hnz1102/GNNS-viewwer/hw/BOM.csv

Reference | Qty | Value | DNP | Footprint | digikey/other
C1,C3 | 2 | 16pF |  | Capacitor_SMD:C_0603_1608Metric | 1292-1490-1-ND
C2,C4,C5,C6,C7,C8,C11,C13,C15 | 9 | 0.1uF |  | Capacitor_SMD:C_0603_1608Metric | 311-1344-1-ND
C9,C10,C18 | 3 | 1uF |  | Capacitor_SMD:C_0805_2012Metric | 1276-1026-1-ND
C12 | 1 | 10nF |  | Capacitor_SMD:C_0603_1608Metric | 311-1085-1-ND
C14,C17 | 2 | 10uF |  | Capacitor_SMD:C_0805_2012Metric | 1276-1096-1-ND
C16 | 1 | 4.7uF |  | Capacitor_SMD:C_0805_2012Metric | 1276-1244-1-ND
D1 | 1 | LED BLUE |  | LED_SMD:LED_0603_1608Metric | 3147-B1931NB--20C007614U1930CT-ND
D2 | 1 | CUS10F30 |  | Diode_SMD:D_SOD-323 | CUS10F30H3FCT-ND
D3 | 1 | LED RED |  | LED_SMD:LED_0603_1608Metric | 3147-B1931URO-20D000114U1930CT-ND
D4 | 1 | LED GREEN |  | LED_SMD:LED_0603_1608Metric | 3147-B1911PG--20D000514U1930CT-ND
FB1,FB2 | 2 | MH2029-601Y |  | Inductor_SMD:L_0805_2012Metric | MH2029-601YCT-ND
J1,J2 | 2 | U.FL-R-SMT-1 |  | Connector_Coaxial:U.FL_Hirose_U.FL-R-SMT-1_Vertical | 26-U.FL-R-SMT-1(80)CT-ND
J3 | 1 | USB4105-GF-A |  | Library:USB_C_5077CR-16-SMC2-BK-TR | 2073-USB4105-GF-ACT-ND
J4 | 1 | B2B-PH-K-S |  | Connector_JST:JST_PH_B2B-PH-K_1x02_P2.00mm_Vertical | 455-1704-ND
L1 | 1 | 47nH |  | Inductor_SMD:L_0603_1608Metric | 490-6582-1-ND
Q1 | 1 | 2N7002K |  | Package_TO_SOT_SMD:SOT-23 | 5399-2N7002KCT-ND
Q2 | 1 | SSM6L56FE_LM |  | Library:SOT-563ES6_TOS | 264-SSM6L56FELMCT-ND
Q3 | 1 | SSM3J332R |  | Package_TO_SOT_SMD:SOT-23 | 4518-SSM3J332RCT-ND
R1,R2,R20 | 3 | 20K 1% |  | Resistor_SMD:R_0603_1608Metric | 311-20.0KHRCT-ND
R3,R4,R5,R8,R9,R12 | 6 | 10K |  | Resistor_SMD:R_0603_1608Metric | 13-RC0603JR-1010KLCT-ND
R6,R7,R10,R11 | 4 | 1K |  | Resistor_SMD:R_0603_1608Metric | 311-1.00KHRCT-ND
R13,R23,R24 | 3 | 330 |  | Resistor_SMD:R_0603_1608Metric | 13-RC0603JR-13330RLCT-ND
R14,R22 | 2 | 100K |  | Resistor_SMD:R_0603_1608Metric | 311-100KGRCT-ND
R15 | 1 | 10 1/8W |  | Resistor_SMD:R_0805_2012Metric | 541-10.0CCT-ND
R16 | 1 | 49.9 |  | Resistor_SMD:R_0603_1608Metric | 311-49.9HRCT-ND
R17,R18 | 2 | 5.1K |  | Resistor_SMD:R_0603_1608Metric | 311-5.1KGRCT-ND
R19 | 1 | 2K |  | Resistor_SMD:R_0603_1608Metric | 311-2.0KGRCT-ND
R21 | 1 | 12K 1% |  | Resistor_SMD:R_0603_1608Metric | 311-12.0KCRT-ND
SW1 | 1 | PAGE/BOOT |  | Button_Switch_THT:SW_PUSH_6mm_H8mm | 2223-TS02-66-70-BK-160-LCR-D-ND
SW2 | 1 | ZOOM-IN |  | Button_Switch_THT:SW_PUSH_6mm_H8mm | 2223-TS02-66-70-BK-160-LCR-D-ND
SW3 | 1 | MODE |  | Button_Switch_THT:SW_PUSH_6mm_H8mm | 2223-TS02-66-70-BK-160-LCR-D-ND
SW4 | 1 | ZOOM-OUT |  | Button_Switch_THT:SW_PUSH_6mm_H8mm | 2223-TS02-66-70-BK-160-LCR-D-ND
SW5 | 1 | SLIDE_SW |  | Library:SLIDE_SW_IS1235-G | SLIDE_SW_IS1235-G https://akizukidenshi.com/catalog/g/g115368/
U1 | 1 | ESP32-S3-WROOM-1-N16R8 |  | Library:ESP32-S3-WROOM-1_EXP | 1965-ESP32-S3-WROOM-1-N16R8CT-ND
U2 | 1 | ST7789V_TFT_DISPLAY_8P |  | Library:ST7789V TFT SPI DISPLAY 320x240 GMT020-02-8P | GMT020-02-8P
U3 | 1 | FEMC064G-M11 |  | Library:EM32VSUKN FPGA153 | 3052-FEMC064G-M11-ND
U4 | 1 | MAX-F10S-00B |  | Library:MAX-F10S_UBL | 672-MAX-F10S-00BCT-ND
U5 | 1 | SPX3819M5-L |  | Package_TO_SOT_SMD:SOT-23-5 | 1016-1871-1-ND
U6 | 1 | MCP73831T-2ATI/OT |  | Package_TO_SOT_SMD:SOT-23-5 | MCP73831T-2ATI/OTCT-ND
Y1 | 1 | 32.7680KHz |  | Crystal:Crystal_SMD_3215-2Pin_3.2x1.5mm | 2151-RT3215-32.768-12.5-TRCT-ND
