hnz1102/GNNS-viewwer/hw/production/bom.csv

Designator | Footprint | Quantity | Value | LCSC Part #
C1, C3 | 0603 | 2 | 16pF
C10, C18, C9 | 0805 | 3 | 1uF
C11, C13, C15, C2, C4, C5, C6, C7, C8 | 0603 | 9 | 0.1uF
C12 | 0603 | 1 | 10nF
C14, C17 | 0805 | 2 | 10uF
C16 | 0805 | 1 | 4.7uF
D1 | 0603 | 1 | LED BLUE
D2 | D_SOD-323 | 1 | CUS10F30
D3 | 0603 | 1 | LED RED
D4 | 0603 | 1 | LED GREEN
FB1, FB2 | 0805 | 2 | MH2029-601Y
J1, J2 | U.FL_Hirose_U.FL-R-SMT-1_Vertical | 2 | Conn_Coaxial
J3 | USB_C_5077CR-16-SMC2-BK-TR | 1 | USB4105-GF-A
J4 | JST_PH_B2B-PH-K_1x02_P2.00mm_Vertical | 1 | LiPo BATTERY
L1 | 0603 | 1 | 47nH
Q1 | SOT-23 | 1 | 2N7002K
Q2 | SOT-563ES6_TOS | 1 | SSM6L56FE_LM
Q3 | SOT-23 | 1 | SSM3J332R
R1, R2, R20 | 0603 | 3 | 20K 1%
R10, R11, R6, R7 | 0603 | 4 | 1K
R12, R3, R4, R5, R8, R9 | 0603 | 6 | 10K
R13, R23, R24 | 0603 | 3 | 330
R14, R22 | 0603 | 2 | 100K
R15 | 0805 | 1 | 10 1/4W
R16 | 0603 | 1 | 49.9
R17, R18 | 0603 | 2 | 5.1K
R19 | 0603 | 1 | 2K
R21 | 0603 | 1 | 12K 1%
SW1 | SW_PUSH_6mm_H8mm | 1 | PAGE/BOOT
SW2 | SW_PUSH_6mm_H8mm | 1 | ZOOM-IN
SW3 | SW_PUSH_6mm_H8mm | 1 | MODE
SW4 | SW_PUSH_6mm_H8mm | 1 | ZOOM-OUT
SW5 | SLIDE_SW_IS1235-G | 1 | SLIDE_SW
U1 | ESP32-S3-WROOM-1_EXP | 1 | ESP32-S3-WROOM-1-N16R8
U2 | ST7789V TFT SPI DISPLAY 320x240 GMT020-02-8P | 1 | ST7789V_TFT_DISPLAY_8P
U3 | EM32VSUKN FPGA153 | 1 | EM64VSUKN-BA000-2
U4 | MAX-F10S_UBL | 1 | MAX-F10S-00B
U5 | SOT-23-5 | 1 | SPX3819M5-L
U6 | SOT-23-5 | 1 | MCP73831-2-OT
Y1 | Crystal_SMD_3215-2Pin_3.2x1.5mm | 1 | 32.7680KHz
