hnz1102/GNNS-viewwer/STL/bottom.stl

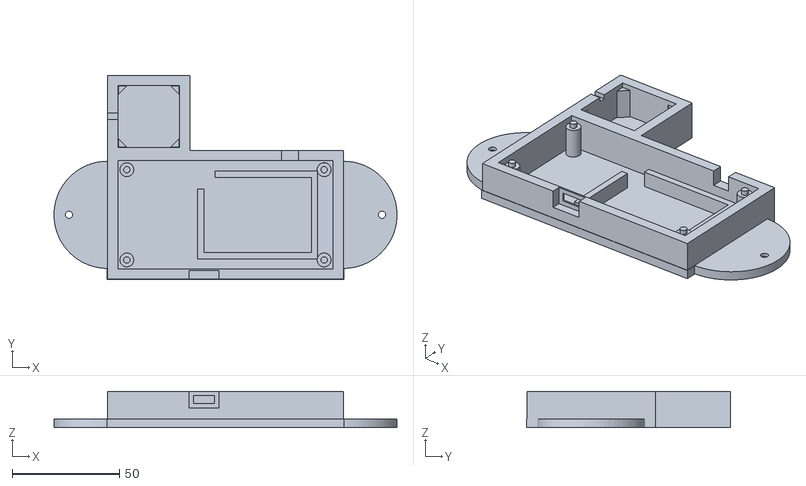
[picture p22: CAD file, 2026-10-10]
STL/bottom.stl
159.9 x 95.2 x 17.0
