hnz1102/GNNS-viewwer/STL/upper.stl

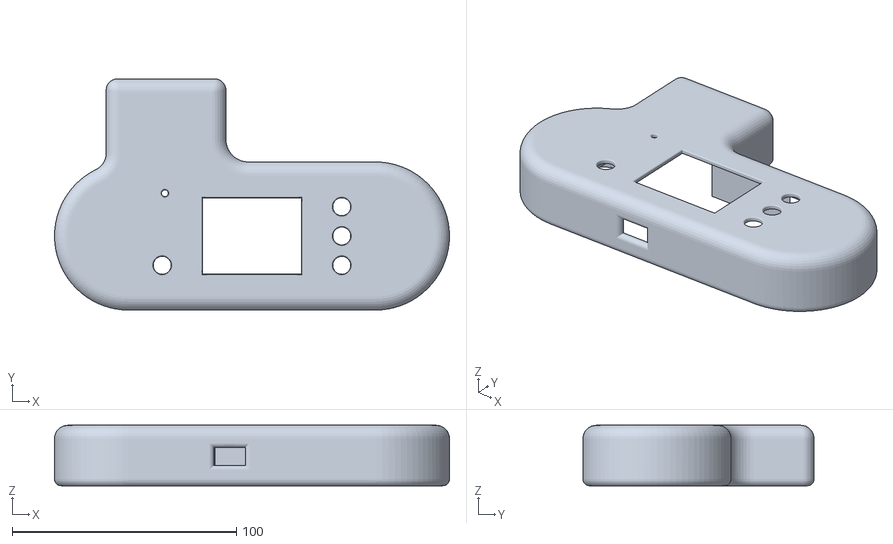
[picture p23: CAD file, 2026-10-10]
STL/upper.stl
176.0 x 103.0 x 27.0
