hnz1102/GNNS-viewwer/STL/sw-cover.stl

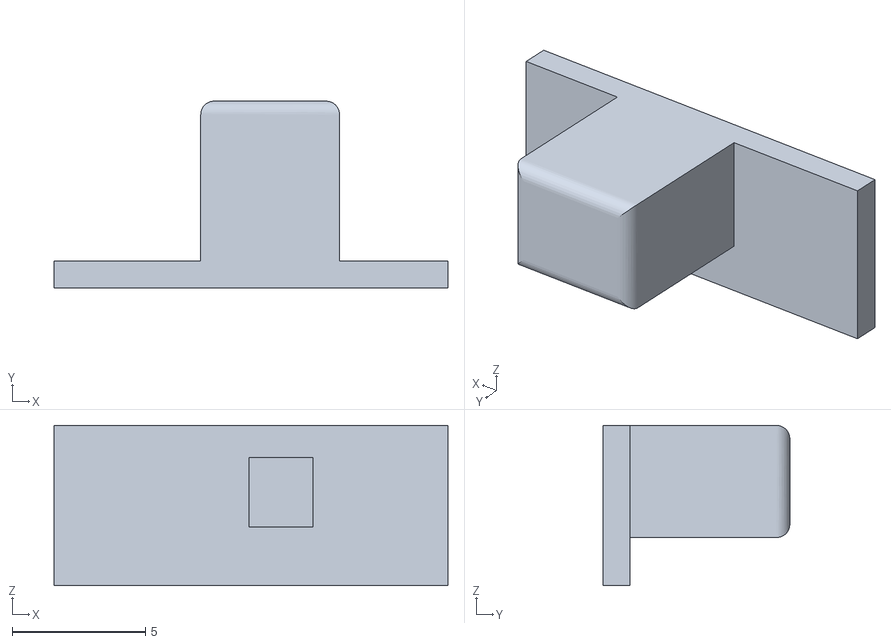
[picture p24: CAD file, 2026-10-10]
STL/sw-cover.stl
14.8 x 7.00 x 6.00
