hnz1102/GNNS-viewwer/STL/button.stl

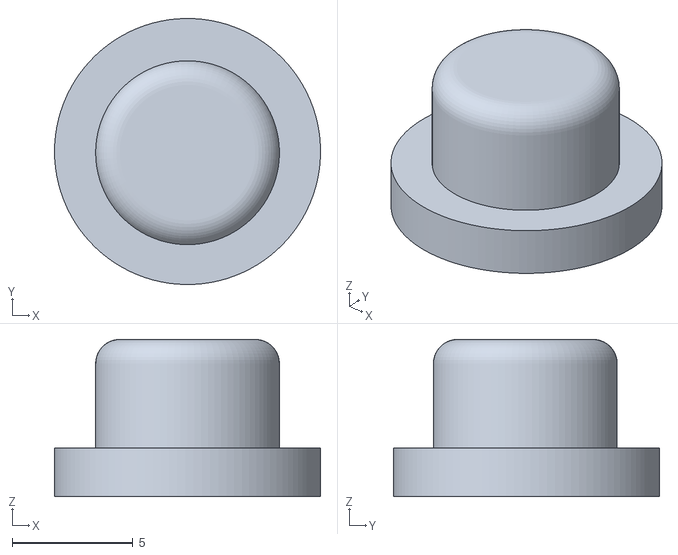
[picture p25: CAD file, 2026-10-10]
STL/button.stl
11.0 x 11.0 x 6.50
