hnz1102/GNNS-viewwer/(list of files, cad)

Other CAD files:
STL/GNSS-VIEWER.f3d
