hnz1102/GNNS-viewwer/hw/GNSS-satellite-viewer.kicad_pcb

## KiCad design hw/GNSS-satellite-viewer.kicad_pcb (2026-10-10)

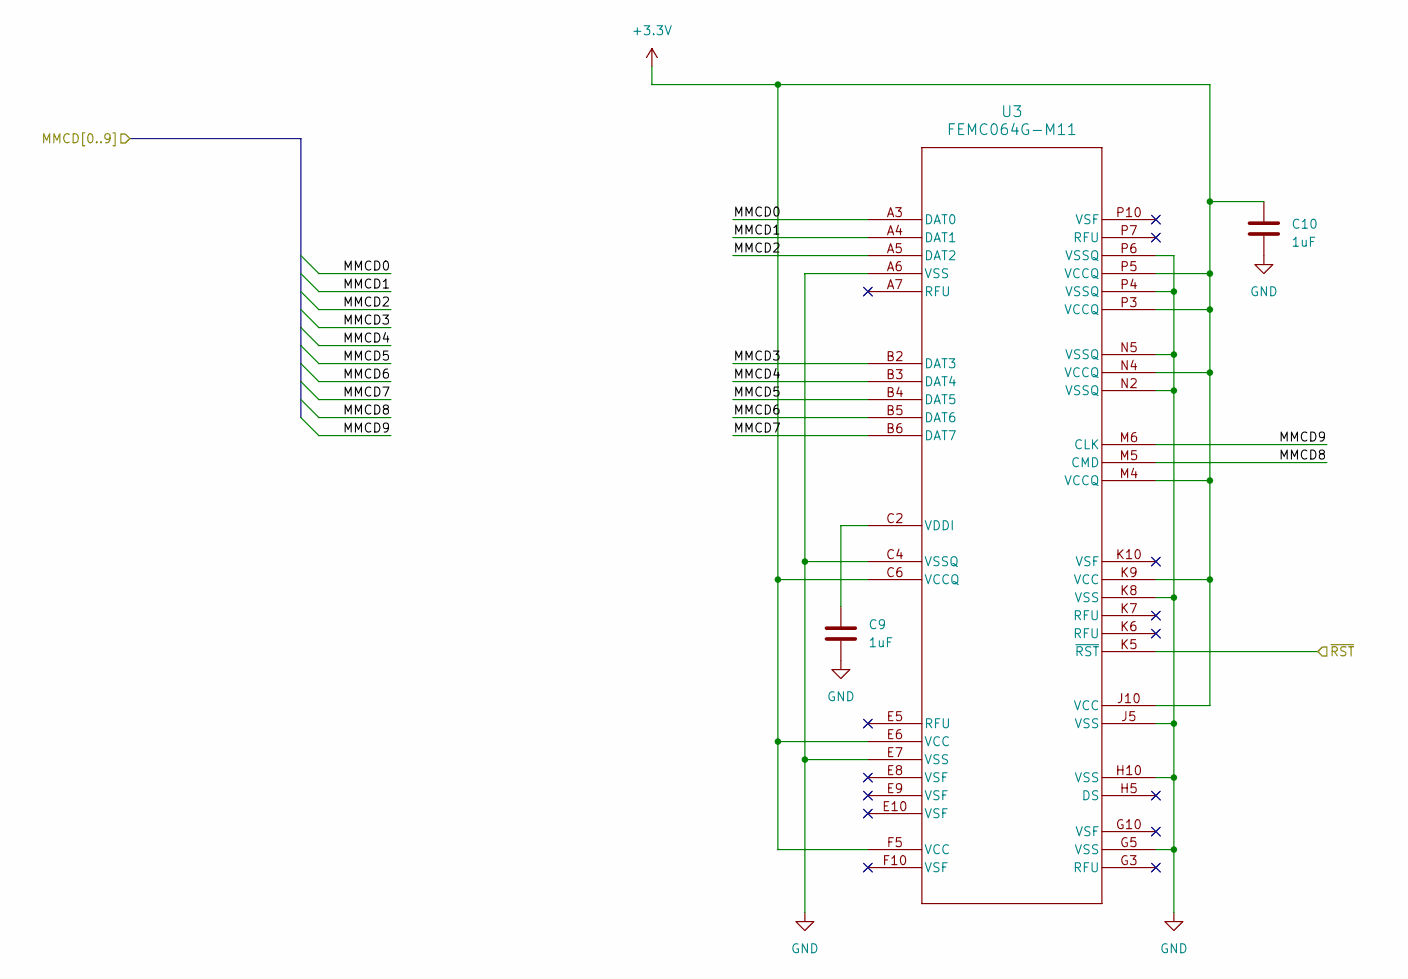
[picture p31: schematic emmc.kicad_sch, GNSS Satellite Viewer]

Parts:
C9, C10: 1uF; C_0805_2012Metric; digikey 1276-1026-1-ND
U3: FEMC064G-M11; EM32VSUKN FPGA153; digikey 3052-FEMC064G-M11-ND

Connections:
+3.3V: C10.1, U3.C6 (VCCQ), U3.E6 (VCC), U3.F5 (VCC), U3.J10 (VCC), U3.K9 (VCC), U3.M4 (VCCQ), U3.N4 (VCCQ), U3.P3 (VCCQ), U3.P5 (VCCQ); also elsewhere on the board
/MPU/MMCD0: U3.A3 (DAT0); also elsewhere on the board
/MPU/MMCD1: U3.A4 (DAT1); also elsewhere on the board
/MPU/MMCD2: U3.A5 (DAT2); also elsewhere on the board
/MPU/MMCD3: U3.B2 (DAT3); also elsewhere on the board
/MPU/MMCD4: U3.B3 (DAT4); also elsewhere on the board
/MPU/MMCD5: U3.B4 (DAT5); also elsewhere on the board
/MPU/MMCD6: U3.B5 (DAT6); also elsewhere on the board
/MPU/MMCD7: U3.B6 (DAT7); also elsewhere on the board
/MPU/MMCD8: U3.M5 (CMD); also elsewhere on the board
/MPU/MMCD9: U3.M6 (CLK); also elsewhere on the board
/MPU/~RESET: U3.K5 (~RST); also elsewhere on the board
GND: C9.2, C10.2, U3.A6 (VSS), U3.C4 (VSSQ), U3.E7 (VSS), U3.G5 (VSS), U3.H10 (VSS), U3.J5 (VSS), U3.K8 (VSS), U3.N2 (VSSQ), U3.N5 (VSSQ), U3.P4 (VSSQ), U3.P6 (VSSQ); also elsewhere on the board
unnamed: C9.1, U3.C2 (VDDI)

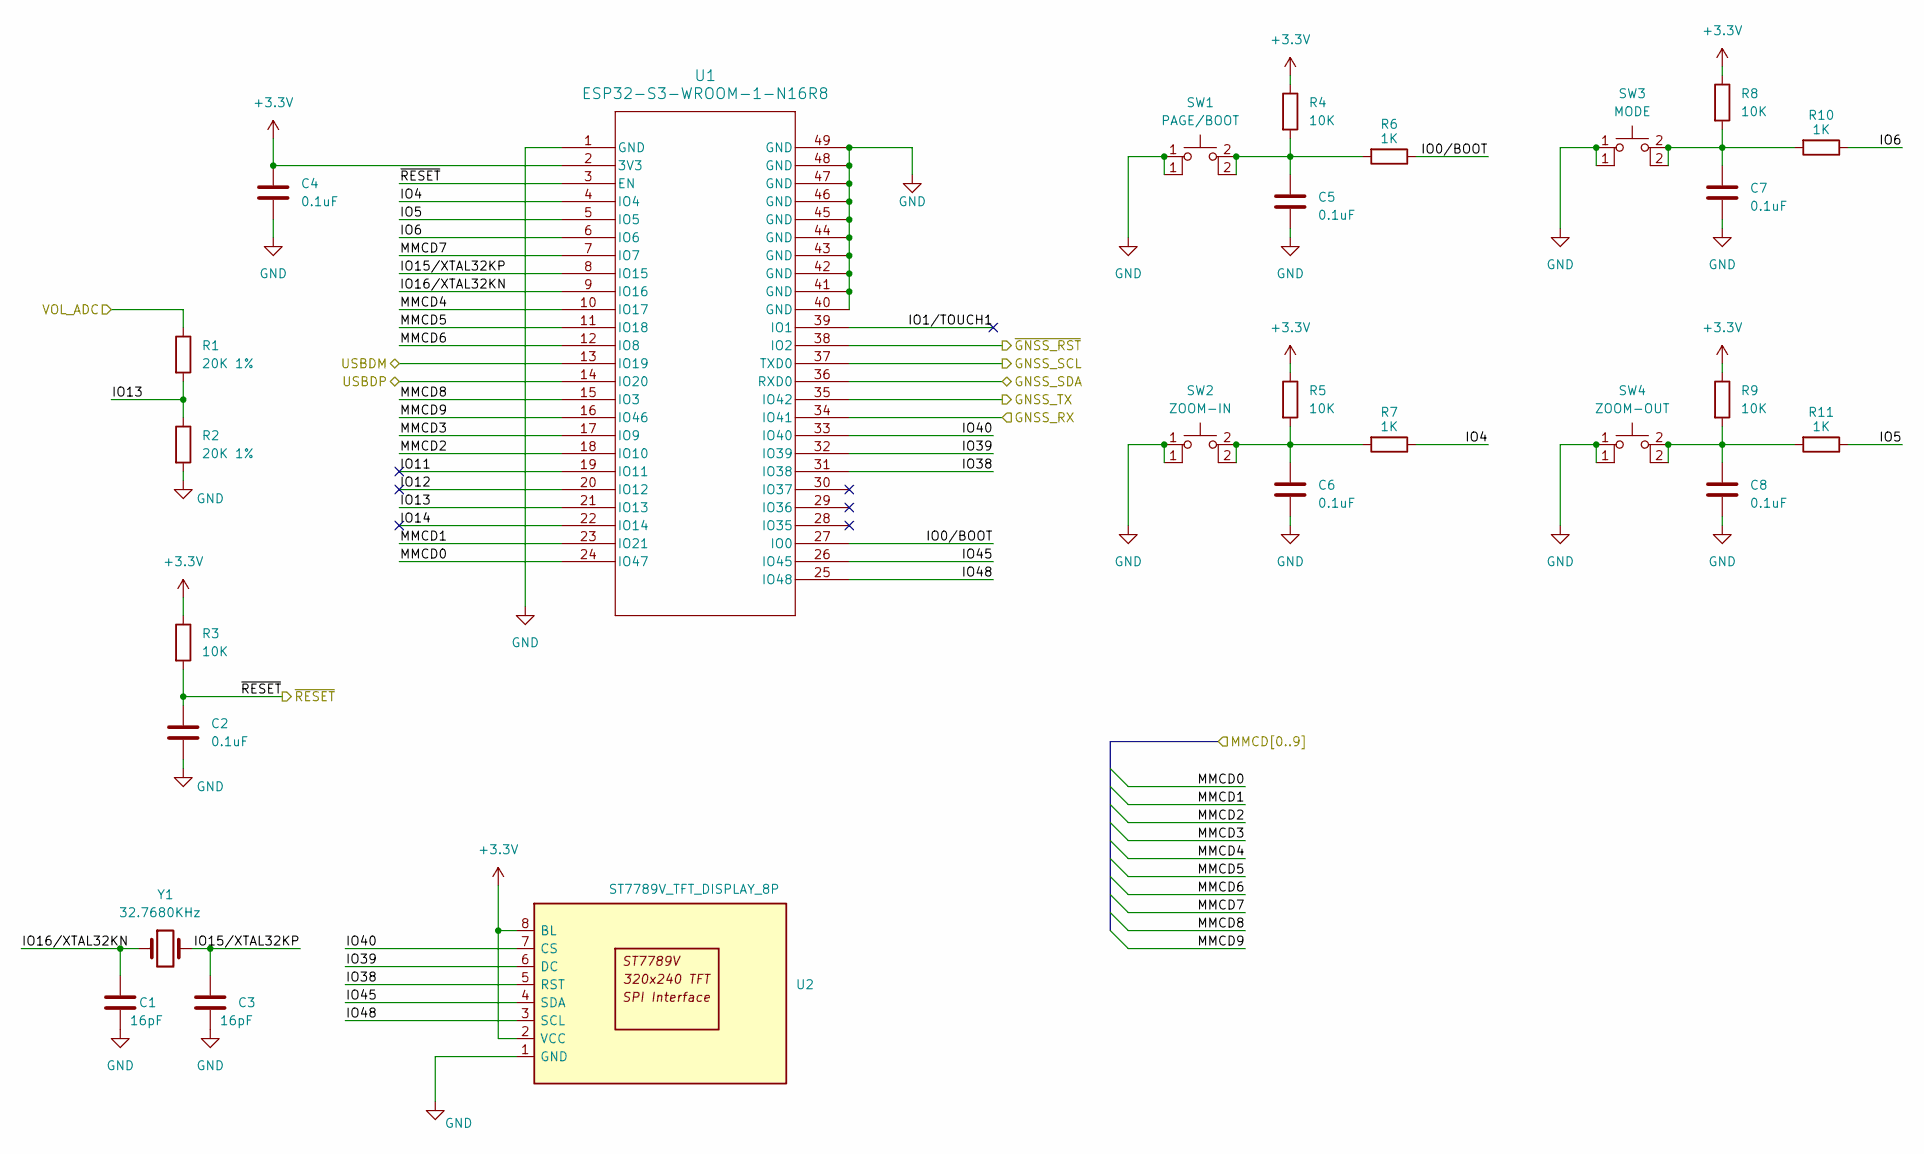
[picture p32: schematic MPU.kicad_sch, GNSS Satellite Viewer]

Parts:
C1, C3: 16pF; C_0603_1608Metric; digikey 1292-1490-1-ND
C2, C4, C5, C6, C7, C8: 0.1uF; C_0603_1608Metric; digikey 311-1344-1-ND
R1, R2: 20K 1%; R_0603_1608Metric; digikey 311-20.0KHRCT-ND
R3, R4, R5, R8, R9: 10K; R_0603_1608Metric; digikey 13-RC0603JR-1010KLCT-ND
R6, R7, R10, R11: 1K; R_0603_1608Metric; digikey 311-1.00KHRCT-ND
SW1: PAGE/BOOT; SW_PUSH_6mm_H8mm; digikey 2223-TS02-66-70-BK-160-LCR-D-ND
SW2: ZOOM-IN; SW_PUSH_6mm_H8mm; digikey 2223-TS02-66-70-BK-160-LCR-D-ND
SW3: MODE; SW_PUSH_6mm_H8mm; digikey 2223-TS02-66-70-BK-160-LCR-D-ND
SW4: ZOOM-OUT; SW_PUSH_6mm_H8mm; digikey 2223-TS02-66-70-BK-160-LCR-D-ND
U1: ESP32-S3-WROOM-1-N16R8; ESP32-S3-WROOM-1_EXP; digikey 1965-ESP32-S3-WROOM-1-N16R8CT-ND
U2: ST7789V_TFT_DISPLAY_8P; ST7789V TFT SPI DISPLAY 320x240 GMT020-02-8P; digikey GMT020-02-8P
Y1: 32.7680KHz; Crystal_SMD_3215-2Pin_3.2x1.5mm; digikey 2151-RT3215-32.768-12.5-TRCT-ND

Connections:
+3.3V: C4.1, R3.1, R4.1, R5.1, R8.1, R9.1, U1.2 (3V3), U2.2 (VCC), U2.8 (BL); also elsewhere on the board
/GNSS-RF/GNSS_RX: U1.35 (IO42); also elsewhere on the board
/GNSS-RF/GNSS_SCL: U1.37 (TXD0); also elsewhere on the board
/GNSS-RF/GNSS_SDA: U1.36 (RXD0); also elsewhere on the board
/GNSS-RF/GNSS_TX: U1.34 (IO41); also elsewhere on the board
/GNSS-RF/~GNSS_RST: U1.38 (IO2); also elsewhere on the board
/MPU/IO0/BOOT: R6.1, U1.27 (IO0)
/MPU/IO1/TOUCH1: U1.39 (IO1)
/MPU/IO4: R7.1, U1.4 (IO4)
/MPU/IO5: R11.1, U1.5 (IO5)
/MPU/IO6: R10.1, U1.6 (IO6)
/MPU/IO11: U1.19 (IO11)
/MPU/IO12: U1.20 (IO12)
/MPU/IO13: R1.2, R2.1, U1.21 (IO13)
/MPU/IO14: U1.22 (IO14)
/MPU/IO15/XTAL32KP: C3.1, U1.8 (IO15), Y1.2
/MPU/IO16/XTAL32KN: C1.1, U1.9 (IO16), Y1.1
/MPU/IO38: U1.31 (IO38), U2.5 (RST)
/MPU/IO39: U1.32 (IO39), U2.6 (DC)
/MPU/IO40: U1.33 (IO40), U2.7 (CS)
/MPU/IO45: U1.26 (IO45), U2.4 (SDA)
/MPU/IO48: U1.25 (IO48), U2.3 (SCL)
/MPU/MMCD0: U1.24 (IO47); also elsewhere on the board
/MPU/MMCD1: U1.23 (IO21); also elsewhere on the board
/MPU/MMCD2: U1.18 (IO10); also elsewhere on the board
/MPU/MMCD3: U1.17 (IO9); also elsewhere on the board
/MPU/MMCD4: U1.10 (IO17); also elsewhere on the board
/MPU/MMCD5: U1.11 (IO18); also elsewhere on the board
/MPU/MMCD6: U1.12 (IO8); also elsewhere on the board
/MPU/MMCD7: U1.7 (IO7); also elsewhere on the board
/MPU/MMCD8: U1.15 (IO3); also elsewhere on the board
/MPU/MMCD9: U1.16 (IO46); also elsewhere on the board
/MPU/USBDM: U1.13 (IO19); also elsewhere on the board
/MPU/USBDP: U1.14 (IO20); also elsewhere on the board
/MPU/~RESET: C2.1, R3.2, U1.3 (EN); also elsewhere on the board
/power/VOUT: R1.1; also elsewhere on the board
GND: C1.2, C2.2, C3.2, C4.2, C5.2, C6.2, C7.2, C8.2, R2.2, SW1.1, SW2.1, SW3.1, SW4.1, U1.1 (GND), U1.40 (GND), U1.41 (GND), U1.42 (GND), U1.43 (GND), U1.44 (GND), U1.45 (GND), U1.46 (GND), U1.47 (GND), U1.48 (GND), U1.49 (GND), U2.1 (GND); also elsewhere on the board
unnamed: C5.1, R4.2, R6.2, SW1.2
unnamed: C6.1, R5.2, R7.2, SW2.2
unnamed: C7.1, R8.2, R10.2, SW3.2
unnamed: C8.1, R9.2, R11.2, SW4.2

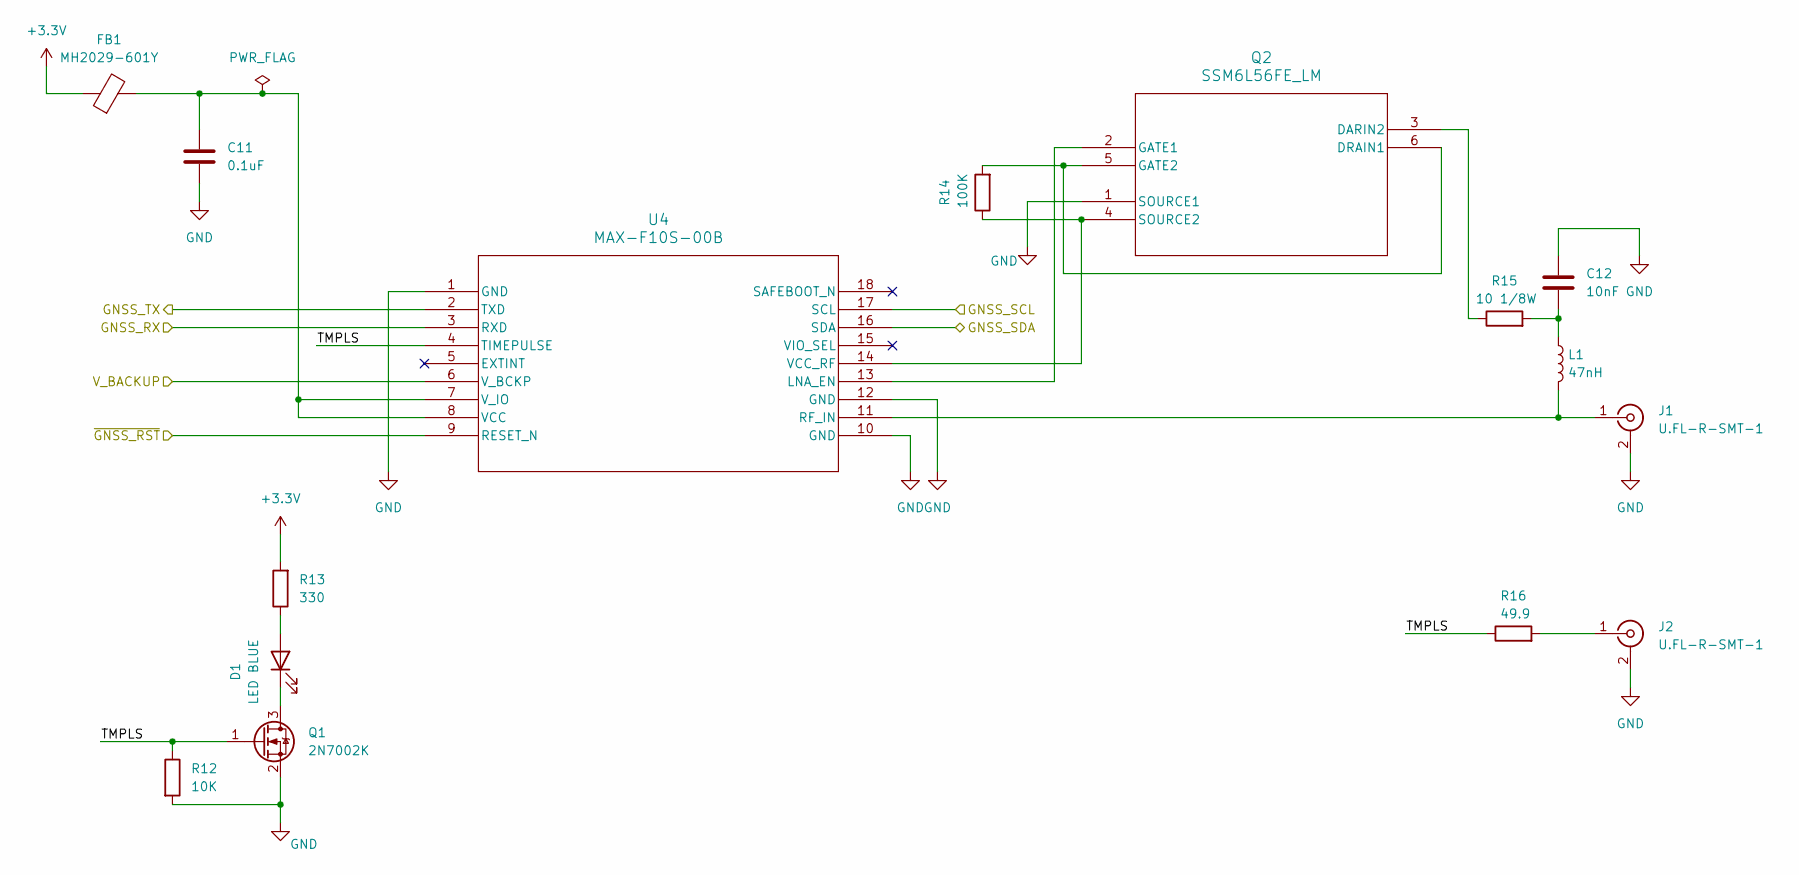
[picture p33: schematic GNSS-RF.kicad_sch, GNSS Satellite Viewer]

Parts:
C11: 0.1uF; C_0603_1608Metric; digikey 311-1344-1-ND
C12: 10nF; C_0603_1608Metric; digikey 311-1085-1-ND
D1: LED BLUE; LED_0603_1608Metric; digikey 3147-B1931NB--20C007614U1930CT-ND
FB1: MH2029-601Y; L_0805_2012Metric; digikey MH2029-601YCT-ND
J1, J2: U.FL-R-SMT-1; U.FL_Hirose_U.FL-R-SMT-1_Vertical; digikey 26-U.FL-R-SMT-1(80)CT-ND
L1: 47nH; L_0603_1608Metric; digikey 490-6582-1-ND
Q1: 2N7002K; SOT-23; digikey 5399-2N7002KCT-ND
Q2: SSM6L56FE_LM; SOT-563ES6_TOS; digikey 264-SSM6L56FELMCT-ND
R12: 10K; R_0603_1608Metric; digikey 13-RC0603JR-1010KLCT-ND
R13: 330; R_0603_1608Metric; digikey 13-RC0603JR-13330RLCT-ND
R14: 100K; R_0603_1608Metric; digikey 311-100KGRCT-ND
R15: 10 1/8W; R_0805_2012Metric; digikey 541-10.0CCT-ND
R16: 49.9; R_0603_1608Metric; digikey 311-49.9HRCT-ND
U4: MAX-F10S-00B; MAX-F10S_UBL; digikey 672-MAX-F10S-00BCT-ND

Connections:
+3.3V: FB1.1, R13.2; also elsewhere on the board
/GNSS-RF/GNSS_RX: U4.3 (RXD); also elsewhere on the board
/GNSS-RF/GNSS_SCL: U4.17 (SCL); also elsewhere on the board
/GNSS-RF/GNSS_SDA: U4.16 (SDA); also elsewhere on the board
/GNSS-RF/GNSS_TX: U4.2 (TXD); also elsewhere on the board
/GNSS-RF/TMPLS: Q1.1 (G), R12.1, R16.1, U4.4 (TIMEPULSE)
/GNSS-RF/V_BACKUP: U4.6 (V_BCKP); also elsewhere on the board
/GNSS-RF/~GNSS_RST: U4.9 (RESET_N); also elsewhere on the board
GND: C11.2, C12.1, J1.2 (Ext), J2.2 (Ext), Q1.2 (S), Q2.1 (SOURCE1), R12.2, U4.1 (GND), U4.10 (GND), U4.12 (GND); also elsewhere on the board
unnamed: C12.2, L1.1, R15.2
unnamed: D1.2 (A), R13.1
unnamed: D1.1 (K), Q1.3 (D)
unnamed: J1.1 (In), L1.2, U4.11 (RF_IN)
unnamed: J2.1 (In), R16.2
unnamed: Q2.3 (DARIN2), R15.1
unnamed: Q2.5 (GATE2), Q2.6 (DRAIN1), R14.2
unnamed: Q2.2 (GATE1), U4.13 (LNA_EN)
unnamed: Q2.4 (SOURCE2), R14.1, U4.14 (VCC_RF)
unnamed: C11.1, FB1.2, U4.7 (V_IO), U4.8 (VCC)

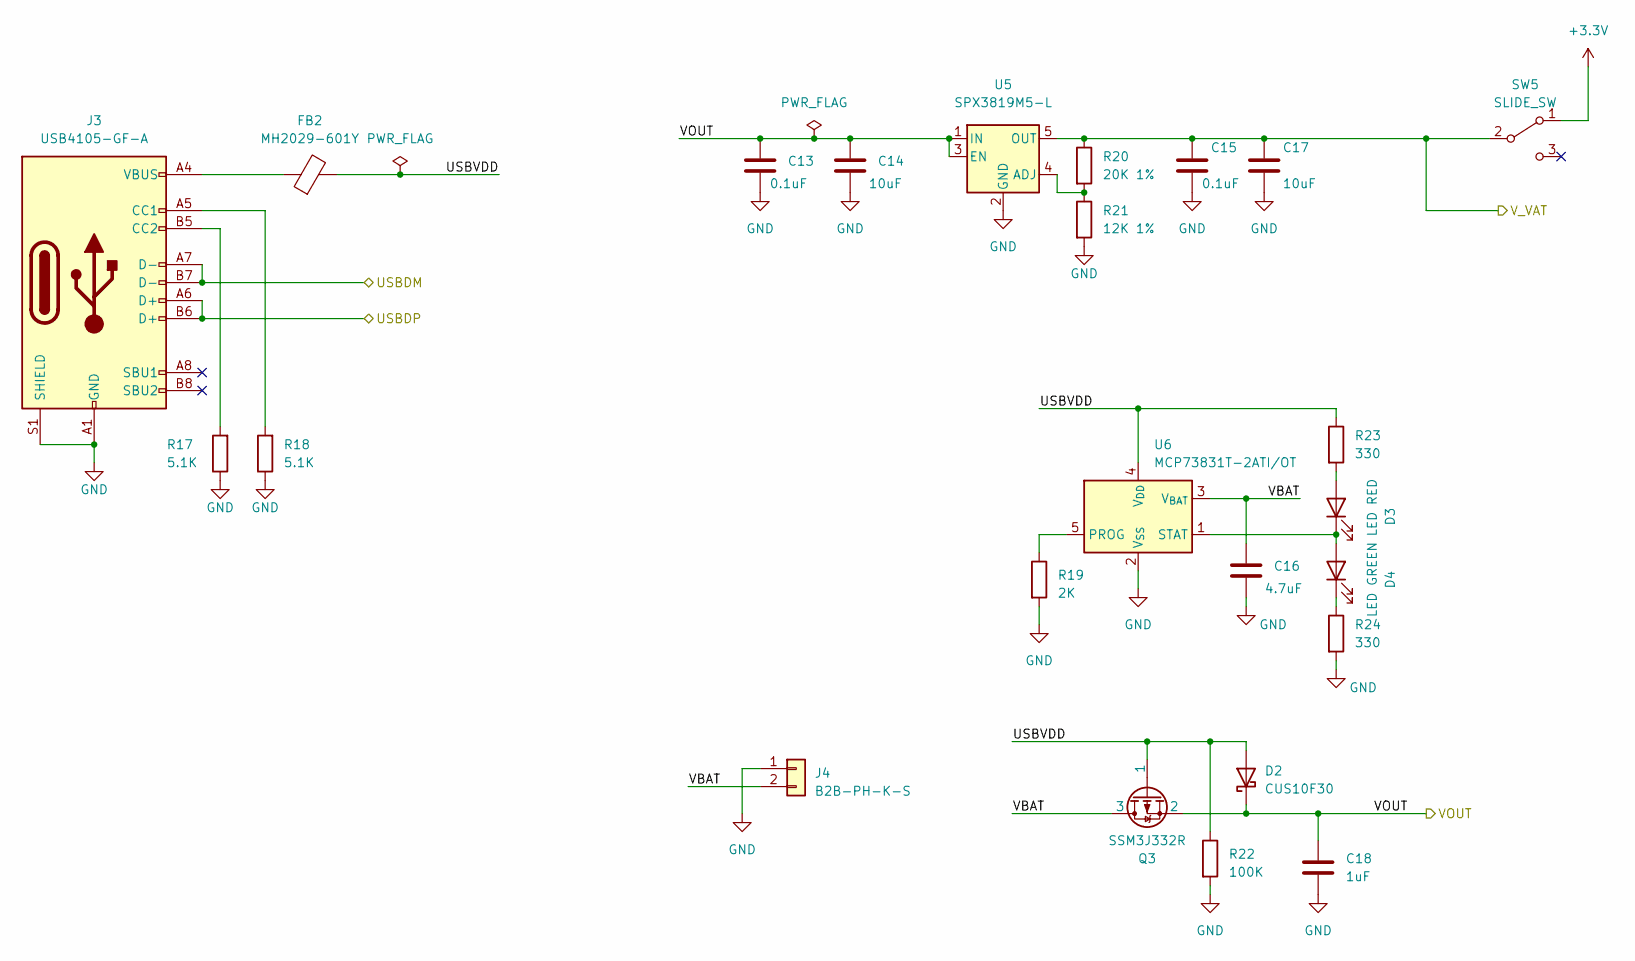
[picture p34: schematic power.kicad_sch, GNSS Satellite Viewer]

Parts:
C13, C15: 0.1uF; C_0603_1608Metric; digikey 311-1344-1-ND
C14, C17: 10uF; C_0805_2012Metric; digikey 1276-1096-1-ND
C16: 4.7uF; C_0805_2012Metric; digikey 1276-1244-1-ND
C18: 1uF; C_0805_2012Metric; digikey 1276-1026-1-ND
D2: CUS10F30; D_SOD-323; digikey CUS10F30H3FCT-ND
D3: LED RED; LED_0603_1608Metric; digikey 3147-B1931URO-20D000114U1930CT-ND
D4: LED GREEN; LED_0603_1608Metric; digikey 3147-B1911PG--20D000514U1930CT-ND
FB2: MH2029-601Y; L_0805_2012Metric; digikey MH2029-601YCT-ND
J3: USB4105-GF-A; USB_C_5077CR-16-SMC2-BK-TR; digikey 2073-USB4105-GF-ACT-ND
J4: B2B-PH-K-S; JST_PH_B2B-PH-K_1x02_P2.00mm_Vertical; digikey 455-1704-ND
Q3: SSM3J332R; SOT-23; digikey 4518-SSM3J332RCT-ND
R17, R18: 5.1K; R_0603_1608Metric; digikey 311-5.1KGRCT-ND
R19: 2K; R_0603_1608Metric; digikey 311-2.0KGRCT-ND
R20: 20K 1%; R_0603_1608Metric; digikey 311-20.0KHRCT-ND
R21: 12K 1%; R_0603_1608Metric; digikey 311-12.0KCRT-ND
R22: 100K; R_0603_1608Metric; digikey 311-100KGRCT-ND
R23, R24: 330; R_0603_1608Metric; digikey 13-RC0603JR-13330RLCT-ND
SW5: SLIDE_SW; SLIDE_SW_IS1235-G; digikey SLIDE_SW_IS1235-G https://akizukidenshi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
U5: SPX3819M5-L; SOT-23-5; digikey 1016-1871-1-ND
U6: MCP73831T-2ATI/OT; SOT-23-5; digikey MCP73831T-2ATI/OTCT-ND

Connections:
+3.3V: SW5.1 (A); also elsewhere on the board
/GNSS-RF/V_BACKUP: C15.1, C17.1, R20.1, SW5.2 (B), U5.5 (OUT); also elsewhere on the board
/MPU/USBDM: J3.A7 (D-), J3.B7 (D-); also elsewhere on the board
/MPU/USBDP: J3.A6 (D+), J3.B6 (D+); also elsewhere on the board
/power/USBVDD: D2.2 (A), FB2.2, Q3.1, R22.1, R23.1, U6.4 (V_{DD})
/power/VBAT: C16.1, J4.2, Q3.3, U6.3 (V_{BAT})
/power/VOUT: C13.1, C14.1, C18.1, D2.1 (K), Q3.2, U5.1 (IN), U5.3 (EN); also elsewhere on the board
GND: C13.2, C14.2, C15.2, C16.2, C17.2, C18.2, J3.A1 (GND), J3.A12 (GND), J3.B1 (GND), J3.B12 (GND), J3.S1 (SHIELD), J4.1, R17.1, R18.1, R19.2, R21.2, R22.2, R24.2, U5.2 (GND), U6.2 (V_{SS}); also elsewhere on the board
unnamed: D3.2 (A), R23.2
unnamed: D3.1 (K), D4.2 (A), U6.1 (STAT)
unnamed: D4.1 (K), R24.1
unnamed: FB2.1, J3.A4 (VBUS), J3.A9 (VBUS), J3.B4 (VBUS), J3.B9 (VBUS)
unnamed: J3.A5 (CC1), R18.2
unnamed: J3.B5 (CC2), R17.2
unnamed: R20.2, R21.1, U5.4 (ADJ)
unnamed: R19.1, U6.5 (PROG)

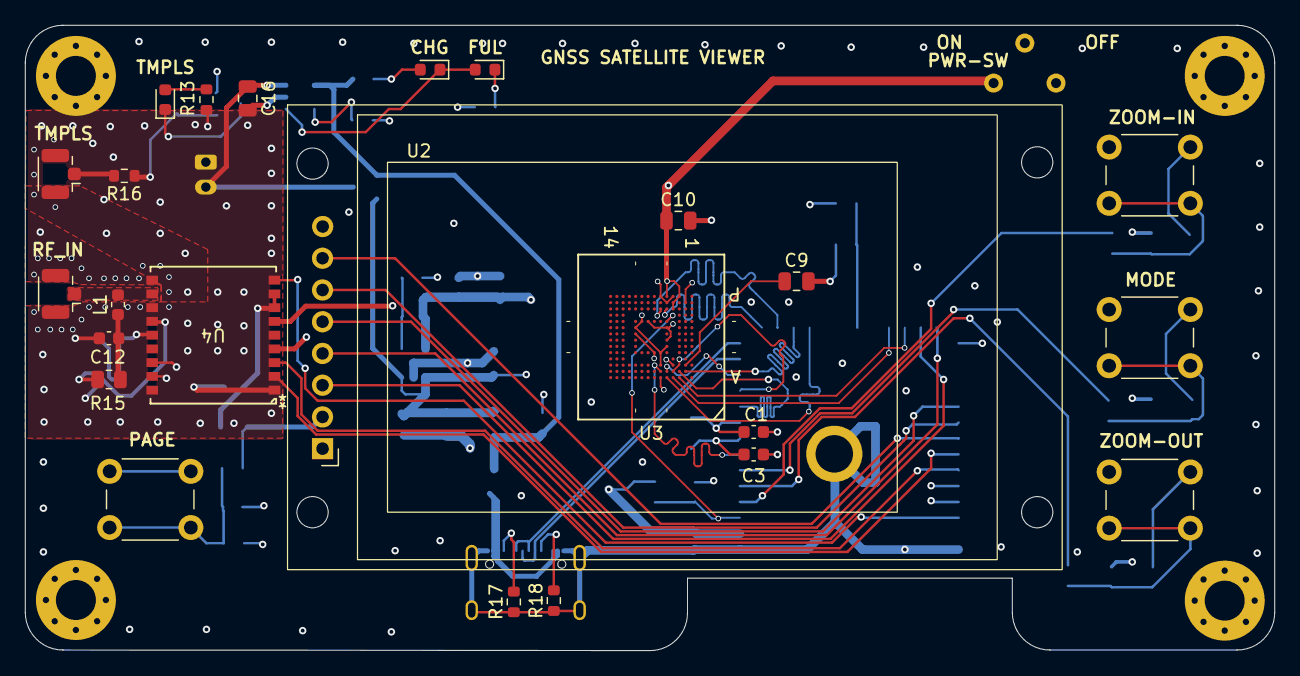
[picture p35: board GNSS-satellite-viewer.kicad_pcb from above]

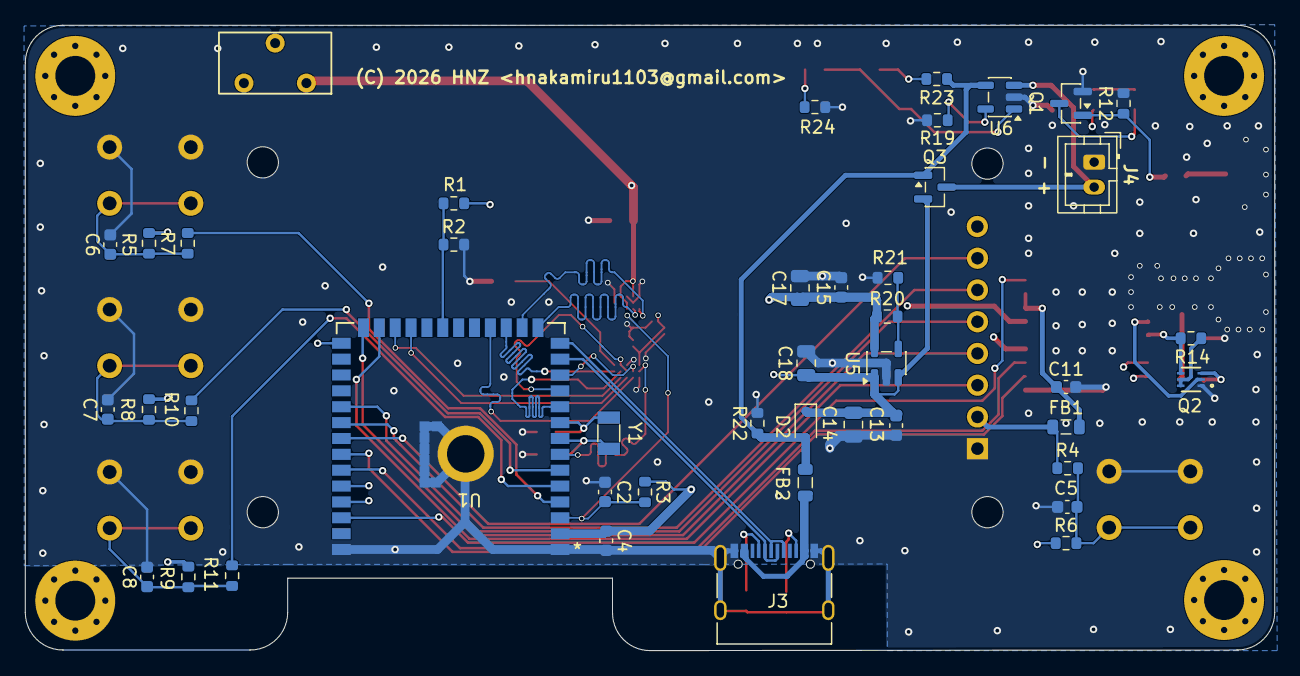
[picture p36: board GNSS-satellite-viewer.kicad_pcb from below]

Board: 4 copper layers, 100.0 x 50.0 mm, 68 parts (44 on the bottom side), 60 nets.
