hnz1102/GNNS-viewwer/src/quake.rs

// Recent earthquakes via the P2P地震情報 JSON API v2 (https://www.p2pquake.net)
// EEW (code 556) arrives over the P2P WebSocket (wss://.../v2/ws), which pushes
// every event as it is registered. Code-551 pushes are merged into the
// recent-earthquake list directly; REST loads the initial list and is polled
// every POLL_SECS only while the WebSocket is down (EEW likewise).
// The TFT quake page, the MAP overlay and the Web UI read the cached state.
// SPDX-License-Identifier: MIT

use log::*;
use std::sync::{LazyLock, Mutex};
use std::sync::atomic::{AtomicBool, AtomicU32, AtomicUsize, Ordering};
use esp_idf_svc::ws::client::{EspWebSocketClient, EspWebSocketClientConfig, WebSocketEventType};
use esp_idf_sys::{heap_caps_get_free_size, MALLOC_CAP_INTERNAL};
use std::thread;
use std::time::{Duration, SystemTime, UNIX_EPOCH};
use embedded_svc::http::client::Client;
use embedded_svc::http::Method;
use embedded_svc::io::Read;
use esp_idf_svc::http::client::{Configuration, EspHttpConnection};
use serde::Deserialize;

/// How many recent events are kept / shown.
pub const QUAKE_MAX: usize = 8;
const POLL_SECS: u64 = 60;
const EEW_POLL_SECS: u64 = 10;
/// Safety re-sync of the list while the WebSocket is up (pushes normally keep it current).
const QUAKE_RESYNC_SECS: u64 = 30 * 60;
/// EEW older than this (by its issue time) is history, not an alert.
const EEW_FRESH_SECS: i64 = 180;
/// How long an EEW overlay / Web UI banner stays up.
const EEW_SHOW_SECS: u64 = 120;
/// Skip a poll when internal RAM is this low: TLS setup would starve the
/// WiFi/lwIP stack (internal heap is the scarce resource on this board).
const MIN_INTERNAL_FREE: u32 = 36 * 1024;
/// Upper bound on one response body (8 events incl. per-station points).
const BODY_MAX: usize = 96 * 1024;

// `--features quake-sandbox` points at the P2P sandbox (replays old 551/556
// data, e.g. a 2023 Hokkaido EEW) and skips the EEW freshness check, so the
// whole alert path can be tested without waiting for a real earthquake.
#[cfg(feature = "quake-sandbox")]
macro_rules! api { ($p:literal) => { concat!("https://api-v2-sandbox.p2pquake.net", $p) }; }
#[cfg(not(feature = "quake-sandbox"))]
macro_rules! api { ($p:literal) => { concat!("https://api.p2pquake.net", $p) }; }
const URL_QUAKE: &str = api!("/v2/history?codes=551&limit=8");
#[cfg(feature = "quake-sandbox")]
const URL_WS: &str = "wss://api-realtime-sandbox.p2pquake.net/v2/ws";
#[cfg(not(feature = "quake-sandbox"))]
const URL_WS: &str = "wss://api.p2pquake.net/v2/ws";
/// WebSocket receive buffer. >4 KB lands in PSRAM (SPIRAM_MALLOC_ALWAYSINTERNAL),
/// and a large EEW (100+ areas) is ~16 KB, so keep it comfortably above that.
const WS_BUF: usize = 32 * 1024;
/// Max size of one reassembled WebSocket message we keep.
const WS_MSG_MAX: usize = 64 * 1024;
/// Free internal RAM needed before (re)creating the WebSocket client.
const WS_MIN_INTERNAL_FREE: u32 = 44 * 1024;
const URL_EEW:   &str = api!("/v2/history?codes=556&limit=1");

#[derive(Clone, Debug)]
pub struct Quake {
    pub time:     String, // "2026/10/10 10:20:00" (JST)
    pub name:     String, // Japanese hypocenter name (Web UI only; TFT has no kanji font)
    pub lat:      f64,
    pub lon:      f64,
    pub depth:    i32,    // km; 0 = very shallow, -1 = unknown
    pub mag:      f32,    // -1 = unknown
    pub scale:    i32,    // P2P maxScale code; -1 = unknown
    pub tsunami:  String, // domesticTsunami: None/Unknown/Checking/NonEffective/Watch/Warning
}

impl Quake {
    /// Max seismic intensity as short ASCII ("1".."4", "5-", "5+", "6-", "6+", "7").
    pub fn intensity(&self) -> &'static str { scale_str(self.scale, false) }
    /// Same, in the JMA notation for the Web UI ("5弱" etc.).
    pub fn intensity_jp(&self) -> &'static str { scale_str(self.scale, true) }
}

fn scale_str(scale: i32, jp: bool) -> &'static str {
    match (scale, jp) {
        (10, _) => "1", (20, _) => "2", (30, _) => "3", (40, _) => "4",
        (45, false) => "5-", (45, true) => "5弱",
        (50, false) => "5+", (50, true) => "5強",
        (55, false) => "6-", (55, true) => "6弱",
        (60, false) => "6+", (60, true) => "6強",
        (70, _) => "7",
        _ => "?",
    }
}

static QUAKES: LazyLock<Mutex<Vec<Quake>>> = LazyLock::new(|| Mutex::new(Vec::new()));
/// Bumped whenever the list content changes (redraw trigger).
static VERSION: AtomicU32 = AtomicU32::new(0);
/// Highlighted row on the quake page.
static SEL: AtomicUsize = AtomicUsize::new(0);
/// Epicenter the MAP page is currently centred on (set from the quake page).
static FOCUS: Mutex<Option<(f64, f64)>> = Mutex::new(None);
/// Unix seconds of the last successful fetch (0 = never).
static LAST_OK_SECS: AtomicU32 = AtomicU32::new(0);

/// Whether the feed is switched on (`quake_enable` in cfg.toml). Off by default:
/// the feed holds a TLS connection and ~30 KB of scarce internal RAM.
static ENABLED: AtomicBool = AtomicBool::new(false);
pub fn set_enabled(on: bool) { ENABLED.store(on, Ordering::Relaxed); }
pub fn enabled() -> bool { ENABLED.load(Ordering::Relaxed) }

pub fn get() -> Vec<Quake> { QUAKES.lock().unwrap().clone() }
pub fn version() -> u32 { VERSION.load(Ordering::Relaxed) }
pub fn last_ok_secs() -> u32 { LAST_OK_SECS.load(Ordering::Relaxed) }

pub fn selection() -> usize { SEL.load(Ordering::Relaxed) }

/// Move the highlight by `delta` rows, clamped to the list bounds.
pub fn move_sel(delta: i32) {
    let len = QUAKES.lock().unwrap().len();
    let cur = SEL.load(Ordering::Relaxed) as i32;
    let next = (cur + delta).clamp(0, len.saturating_sub(1) as i32);
    SEL.store(next as usize, Ordering::Relaxed);
    VERSION.fetch_add(1, Ordering::Relaxed);
}

/// Centre the MAP page on the highlighted epicenter. Returns false if none.
pub fn focus_selected() -> bool {
    let q = QUAKES.lock().unwrap().get(SEL.load(Ordering::Relaxed)).cloned();
    match q {
        Some(q) => {
            AUTO_FOCUS.store(false, Ordering::Relaxed);
            *FOCUS.lock().unwrap() = Some((q.lat, q.lon));
            // M7-class quakes need a regional view; keep small ones closer.
            crate::map_display::set_zoom(if q.mag >= 6.0 { 6 } else { 8 });
            crate::map_display::reset_last_pos();
            true
        }
        None => false,
    }
}

pub fn focus() -> Option<(f64, f64)> { *FOCUS.lock().unwrap() }

pub fn clear_focus() {
    AUTO_FOCUS.store(false, Ordering::Relaxed);
    clear_new_quake();
    let mut f = FOCUS.lock().unwrap();
    if f.is_some() {
        *f = None;
        crate::map_display::reset_last_pos();
    }
}

/// True while the MAP focus was set by an EEW (not picked on the quake page).
static AUTO_FOCUS: AtomicBool = AtomicBool::new(false);

/// Great-circle distance in km (haversine).
pub fn distance_km(lat1: f64, lon1: f64, lat2: f64, lon2: f64) -> f64 {
    let (p1, p2) = (lat1.to_radians(), lat2.to_radians());
    let dp = p2 - p1;
    let dl = (lon2 - lon1).to_radians();
    let a = (dp / 2.0).sin().powi(2) + p1.cos() * p2.cos() * (dl / 2.0).sin().powi(2);
    6371.0 * 2.0 * a.sqrt().asin()
}

/// This unit's own position from the GNSS fix, if there is one.
pub fn own_position() -> Option<(f64, f64)> {
    let g = crate::gps_parser::get_data();
    if g.fix_quality > 0 && !g.lat_dd.is_nan() && !g.lon_dd.is_nan() { Some((g.lat_dd, g.lon_dd)) } else { None }
}

/// Map view for an EEW: centred between the epicenter and our own position,
/// at the largest zoom that still shows both. Returns (centre lat, centre lon,
/// zoom, distance in km to the epicenter if our position is known).
/// Without a GNSS fix (or epicenter coordinates) it falls back to a regional
/// view on whichever point is known.
pub fn eew_view(e: &Eew) -> (f64, f64, u8, Option<f64>) {
    fit_view(e.lat, e.lon)
}

/// Same framing for any epicenter (`lat` NaN = unknown).
pub fn fit_view(lat: f64, lon: f64) -> (f64, f64, u8, Option<f64>) {
    let own = own_position();
    match (own, lat.is_nan()) {
        (Some((ol, oo)), false) => {
            let (clat, clon) = ((ol + lat) / 2.0, (oo + lon) / 2.0);
            let z = crate::map_display::zoom_to_fit(
                clat, clon, ol.min(lat), ol.max(lat), oo.min(lon), oo.max(lon));
            (clat, clon, z.min(14), Some(distance_km(ol, oo, lat, lon)))
        }
        (None, false) => (lat, lon, 8, None),
        (Some((ol, oo)), true) => (ol, oo, 8, None),
        (None, true) => (f64::NAN, f64::NAN, 8, None),
    }
}

// ─── Newly received earthquake, shown on the MAP page ────────────────────────

/// How long the "new earthquake" view stays up.
const NEWQ_SHOW_SECS: u64 = 60;

struct NewQuake { q: Quake, expires: u64 }
static NEWQ: Mutex<Option<NewQuake>> = Mutex::new(None);
static NEWQ_VERSION: AtomicU32 = AtomicU32::new(0);

/// The new earthquake being highlighted on the MAP page, if any.
pub fn new_quake() -> Option<Quake> {
    let g = NEWQ.lock().unwrap();
    let n = g.as_ref()?;
    if now_secs() < n.expires { Some(n.q.clone()) } else { None }
}
pub fn newq_version() -> u32 { NEWQ_VERSION.load(Ordering::Relaxed) }

fn clear_new_quake() {
    if NEWQ.lock().unwrap().take().is_some() {
        NEWQ_VERSION.fetch_add(1, Ordering::Relaxed);
    }
}

/// A new earthquake just arrived. If the TFT is on the MAP page (and not
/// replaying a track, and no EEW owns the map), frame its epicenter together
/// with this unit's position and show its details.
fn announce_new(q: &Quake) {
    if crate::serial_display::current_page() != crate::serial_display::PAGE_MAP { return; }
    if crate::track_view::is_playing() || EEW.lock().unwrap().is_some() { return; }
    let (clat, clon, zoom, _) = fit_view(q.lat, q.lon);
    if clat.is_nan() { return; }
    *FOCUS.lock().unwrap() = Some((clat, clon));
    AUTO_FOCUS.store(true, Ordering::Relaxed);
    crate::map_display::set_zoom(zoom);
    crate::map_display::reset_last_pos();
    *NEWQ.lock().unwrap() = Some(NewQuake { q: q.clone(), expires: now_secs() + NEWQ_SHOW_SECS });
    NEWQ_VERSION.fetch_add(1, Ordering::Relaxed);
    info!("[QUAKE] showing new earthquake on MAP: M{:.1} {}", q.mag, q.name);
}

/// Switch the TFT to the MAP page, framing the EEW epicenter and our position.
fn focus_eew(e: &Eew) {
    let (clat, clon, zoom, _) = eew_view(e);
    if clat.is_nan() { return; }
    *FOCUS.lock().unwrap() = Some((clat, clon));
    AUTO_FOCUS.store(true, Ordering::Relaxed);
    crate::map_display::set_zoom(zoom);
    crate::map_display::reset_last_pos();
    crate::serial_display::set_page(crate::serial_display::PAGE_MAP);
}

// ─── Active EEW (緊急地震速報・警報) ──────────────────────────────────────────

#[derive(Clone, Debug)]
pub struct Eew {
    pub time:      String,  // issue time (JST)
    pub name:      String,  // hypocenter name (Japanese)
    pub lat:       f64,     // NaN when the report carries no coordinates
    pub lon:       f64,
    pub depth:     i32,
    pub mag:       f32,
    pub max_scale: i32,     // largest forecast intensity code over the areas, -1 unknown
    pub areas:     String,  // forecast areas (Japanese), comma separated, truncated
    expires:       u64,     // unix secs
}

impl Eew {
    pub fn intensity(&self) -> &'static str { scale_str(self.max_scale, false) }
    pub fn intensity_jp(&self) -> &'static str { scale_str(self.max_scale, true) }
}

static EEW: Mutex<Option<Eew>> = Mutex::new(None);
static EEW_VERSION: AtomicU32 = AtomicU32::new(0);

/// The EEW to show, if one is active (not cancelled / expired).
pub fn eew() -> Option<Eew> {
    let e = EEW.lock().unwrap().clone()?;
    if now_secs() < e.expires { Some(e) } else { None }
}
/// True while the WebSocket is connected (for diagnostics).
pub fn ws_connected() -> bool { WS_CONNECTED.load(Ordering::Relaxed) }
pub fn eew_version() -> u32 { EEW_VERSION.load(Ordering::Relaxed) }

// ─── P2P JSON types (only the fields we use; the rest, e.g. `points`, is skipped) ──

#[derive(Deserialize)]
struct Hypocenter {
    name:      Option<String>,
    latitude:  Option<f64>,
    longitude: Option<f64>,
    depth:     Option<i32>,
    magnitude: Option<f64>,
}

#[derive(Deserialize)]
#[serde(rename_all = "camelCase")]
struct Earthquake {
    time:             Option<String>,
    hypocenter:       Option<Hypocenter>,
    max_scale:        Option<i32>,
    domestic_tsunami: Option<String>,
}

#[derive(Deserialize)]
struct Item {
    earthquake: Option<Earthquake>,
}

#[derive(Deserialize)]
struct EewEq {
    hypocenter: Option<Hypocenter>,
}

#[derive(Deserialize)]
#[serde(rename_all = "camelCase")]
struct EewArea {
    name:       Option<String>,
    scale_from: Option<i32>,
}

#[derive(Deserialize)]
struct EewItem {
    id:         Option<String>,
    time:       Option<String>,
    test:       Option<bool>,
    cancelled:  Option<bool>,
    earthquake: Option<EewEq>,
    areas:      Option<Vec<EewArea>>,
}

fn item_to_quake(it: Item) -> Option<Quake> {
    let eq = it.earthquake?;
    let h = eq.hypocenter?;
    // Intensity-only reports carry no epicenter (lat/lon missing or -200).
    let (lat, lon) = (h.latitude?, h.longitude?);
    if !(-90.0..=90.0).contains(&lat) || !(-180.0..=180.0).contains(&lon) { return None; }
    Some(Quake {
        time:    eq.time.unwrap_or_default(),
        name:    h.name.unwrap_or_default(),
        lat, lon,
        depth:   h.depth.unwrap_or(-1),
        mag:     h.magnitude.map(|m| m as f32).unwrap_or(-1.0),
        scale:   eq.max_scale.unwrap_or(-1),
        tsunami: eq.domestic_tsunami.unwrap_or_default(),
    })
}

/// REST response: array of events, newest first.
fn parse(body: &[u8]) -> Option<Vec<Quake>> {
    let items: Vec<Item> = serde_json::from_slice(body)
        .map_err(|e| info!("[QUAKE] json: {:?}", e))
        .ok()?;
    Some(items.into_iter().filter_map(item_to_quake).take(QUAKE_MAX).collect())
}

/// Merge one event pushed over the WebSocket into the list (newest first).
/// A re-issue of the same event (same origin time + epicenter) replaces it.
fn merge_pushed(body: &[u8]) {
    let q = match serde_json::from_slice::<Item>(body) {
        Ok(it) => match item_to_quake(it) { Some(q) => q, None => return },
        Err(e) => { info!("[QUAKE] pushed json: {:?}", e); return; }
    };
    let mut cur = QUAKES.lock().unwrap();
    let is_new = !cur.iter().any(|o| o.time == q.time && o.lat == q.lat && o.lon == q.lon);
    cur.retain(|o| !(o.time == q.time && o.lat == q.lat && o.lon == q.lon));
    info!("[QUAKE] pushed: {} M{:.1} {}", q.time, q.mag, q.name);
    cur.insert(0, q.clone());
    cur.truncate(QUAKE_MAX);
    VERSION.fetch_add(1, Ordering::Relaxed);
    LAST_OK_SECS.store(now_secs() as u32, Ordering::Relaxed);
    drop(cur);
    // A re-issue of a known event (correction) only updates the list.
    if is_new { announce_new(&q); }
}

/// P2P timestamps ("2026/10/10 10:23:10.944") are JST; returns unix seconds.
fn jst_to_unix(t: &str) -> Option<i64> {
    let t = t.get(..19)?;
    let dt = chrono::NaiveDateTime::parse_from_str(t, "%Y/%m/%d %H:%M:%S").ok()?;
    Some(dt.and_utc().timestamp() - 9 * 3600)
}

/// Handle the newest code-556 entry. `last_id` is the last one already acted on.
fn handle_eew(body: &[u8], last_id: &mut String) {
    // REST returns an array, the WebSocket a single object.
    let it = match serde_json::from_slice::<Vec<EewItem>>(body) {
        Ok(items) => match items.into_iter().next() { Some(it) => it, None => return },
        Err(_) => match serde_json::from_slice::<EewItem>(body) {
            Ok(it) => it,
            Err(e) => { info!("[EEW] json parse failed: {:?}", e); return; }
        },
    };
    let id = it.id.clone().unwrap_or_default();
    if id.is_empty() || id == *last_id { return; }
    *last_id = id.clone();

    if it.test.unwrap_or(false) { info!("[EEW] test message ignored"); return; }
    if it.cancelled.unwrap_or(false) {
        info!("[EEW] cancelled");
        clear_eew();
        return;
    }
    let time = it.time.clone().unwrap_or_default();
    let fresh = cfg!(feature = "quake-sandbox") || jst_to_unix(&time)
        .map(|t| (now_secs() as i64 - t).abs() <= EEW_FRESH_SECS)
        .unwrap_or(false);
    if !fresh { info!("[EEW] stale report ({}) ignored", time); return; }

    let h = it.earthquake.and_then(|e| e.hypocenter);
    let areas = it.areas.unwrap_or_default();
    let max_scale = areas.iter().filter_map(|a| a.scale_from).max().unwrap_or(-1);
    let mut names: Vec<String> = Vec::new();
    for a in &areas {
        if let Some(n) = &a.name { if !names.contains(n) { names.push(n.clone()); } }
    }
    let shown = names.len().min(8);
    let mut area_txt = names[..shown].join("、");
    if names.len() > shown { area_txt.push_str("…"); }

    let eew = Eew {
        time,
        name:  h.as_ref().and_then(|h| h.name.clone()).unwrap_or_default(),
        lat:   h.as_ref().and_then(|h| h.latitude).unwrap_or(f64::NAN),
        lon:   h.as_ref().and_then(|h| h.longitude).unwrap_or(f64::NAN),
        depth: h.as_ref().and_then(|h| h.depth).unwrap_or(-1),
        mag:   h.as_ref().and_then(|h| h.magnitude).map(|m| m as f32).unwrap_or(-1.0),
        max_scale,
        areas: area_txt,
        expires: now_secs() + EEW_SHOW_SECS,
    };
    warn!("[EEW] ALERT M{:.1} maxI={} ({})", eew.mag, eew.intensity(), eew.name);

    // Show it on the TFT map: epicenter + our own position, scaled to fit both.
    focus_eew(&eew);
    *EEW.lock().unwrap() = Some(eew);
    EEW_VERSION.fetch_add(1, Ordering::Relaxed);
}

fn clear_eew() {
    *EEW.lock().unwrap() = None;
    EEW_VERSION.fetch_add(1, Ordering::Relaxed);
    // Hand the map back to the normal GPS-centred view (the page stays as is).
    if AUTO_FOCUS.load(Ordering::Relaxed) {
        clear_focus();
    }
}

// ─── HTTP ─────────────────────────────────────────────────────────────────────

type HttpClient = Client<EspHttpConnection>;

fn new_client() -> Option<HttpClient> {
    let config = Configuration {
        crt_bundle_attach: Some(esp_idf_sys::esp_crt_bundle_attach),
        use_global_ca_store: false,
        buffer_size:    Some(2048),
        buffer_size_tx: Some(512),
        ..Default::default()
    };
    EspHttpConnection::new(&config)
        .map_err(|e| info!("[QUAKE] connection: {:?}", e))
        .ok()
        .map(Client::wrap)
}

/// GET `url` over the shared kept-alive client (created on demand, dropped on
/// any error so the next call starts a fresh connection).
fn http_get(slot: &mut Option<HttpClient>, url: &str) -> Option<Vec<u8>> {
    if slot.is_none() { *slot = new_client(); }
    let client = slot.as_mut()?;
    let headers = [("User-Agent", "satellite-viewer/1.0"), ("Accept", "application/json")];

    let result = (|| {
        let request = client.request(Method::Get, url, &headers)
            .map_err(|e| info!("[QUAKE] request: {:?}", e)).ok()?;
        let mut response = request.submit()
            .map_err(|e| info!("[QUAKE] submit: {:?}", e)).ok()?;
        if response.status() != 200 {
            info!("[QUAKE] HTTP {}", response.status());
            return None;
        }
        // Read to the end even when oversized, so the connection stays reusable.
        let mut body: Vec<u8> = Vec::with_capacity(8 * 1024);
        let mut chunk = [0u8; 1024];
        let mut too_big = false;
        loop {
            match Read::read(&mut response, &mut chunk) {
                Ok(0) => break,
                Ok(n) => {
                    if body.len() + n > BODY_MAX { too_big = true; } else { body.extend_from_slice(&chunk[..n]); }
                }
                Err(_) => return None,
            }
        }
        if too_big { info!("[QUAKE] response too large, dropped"); return None; }
        Some(body)
    })();

    if result.is_none() { *slot = None; }
    result
}

fn now_secs() -> u64 {
    SystemTime::now().duration_since(UNIX_EPOCH).map(|d| d.as_secs()).unwrap_or(0)
}

/// Smallest amount of this thread's stack that has ever been unused (bytes).
fn stack_free() -> u32 {
    unsafe { esp_idf_sys::uxTaskGetStackHighWaterMark(core::ptr::null_mut()) as u32 }
}

fn internal_free() -> u32 {
    unsafe { heap_caps_get_free_size(MALLOC_CAP_INTERNAL) as u32 }
}

// ─── WebSocket ────────────────────────────────────────────────────────────────

/// Fragments of a WebSocket message being reassembled (static so that the
/// callback captures nothing — see `drop_ws`).
static WS_PARTIAL: Mutex<String> = Mutex::new(String::new());
static WS_CONNECTED: AtomicBool = AtomicBool::new(false);
/// True while a WebSocket client object exists (connected or reconnecting).
static WS_ALIVE: AtomicBool = AtomicBool::new(false);
/// Unix secs of the most recent map fetch start (the socket is not re-created
/// while the user is still zooming/panning: each fetch would just drop it again).
static LAST_MAP_FETCH_SECS: AtomicU32 = AtomicU32::new(0);
/// Quiet time after the last map fetch before the WebSocket comes back.
const WS_RESUME_AFTER_MAP_SECS: u32 = 12;
/// Asked by the map fetch worker: drop the WebSocket now to free internal RAM.
static WS_RELEASE: AtomicBool = AtomicBool::new(false);

/// Called by the map fetch worker before it starts a (TLS + JPEG) fetch.
///
/// The WebSocket's TLS session holds ~30 KB of internal RAM for as long as it
/// lives, and a map fetch needs ~45 KB on top of the ~50 KB that is otherwise
/// free — together they dipped the internal heap to 3 KB. So the WebSocket is
/// dropped for the duration of the fetch (blocks up to 3 s until it is gone)
/// and the quake thread re-creates it afterwards. An EEW issued meanwhile is
/// caught by the REST EEW check that runs whenever the socket is down.
pub fn release_ws_for_map() {
    LAST_MAP_FETCH_SECS.store(now_secs() as u32, Ordering::Relaxed);
    if !WS_ALIVE.load(Ordering::Relaxed) { return; }
    WS_RELEASE.store(true, Ordering::Relaxed);
    for _ in 0..60 {
        if !WS_ALIVE.load(Ordering::Relaxed) { return; }
        thread::sleep(Duration::from_millis(50));
    }
    warn!("[WS] release for map fetch timed out");
}
/// Newest complete code-556 message received over the WebSocket, waiting for
/// the quake thread (the WS task has a small stack, so it only hands it over).
static WS_EEW_PENDING: Mutex<Option<String>> = Mutex::new(None);
/// Newest complete code-551 message received over the WebSocket.
static WS_QUAKE_PENDING: Mutex<Option<String>> = Mutex::new(None);

fn ws_dispatch(msg: &str) {
    // Keys are sorted alphabetically, so "code" comes after "areas" etc. — look
    // at the whole message, not just its start.
    if msg.contains("\"code\":556") {
        *WS_EEW_PENDING.lock().unwrap() = Some(msg.to_string());
    } else if msg.contains("\"code\":551") {
        *WS_QUAKE_PENDING.lock().unwrap() = Some(msg.to_string());
    }
}

/// Tear a client down without `EspWebSocketClient`'s own `Drop`.
///
/// That `Drop` does `esp_websocket_client_close(..).unwrap()`, which fails with
/// ESP_FAIL ("Websocket client is not connected") whenever the socket happens to
/// be down at that moment (server-side close, mid-reconnect) — and the unwrap
/// then aborts the whole firmware. So close/destroy the C handle here, ignoring
/// errors, and `forget` the wrapper (leaking only its 16-byte callback box).
fn drop_ws(ws: EspWebSocketClient<'static>) {
    use esp_idf_svc::handle::RawHandle;
    use esp_idf_svc::hal::delay::TickType;
    let h = ws.handle();
    let ticks = TickType::from(Duration::from_secs(2)).0;
    unsafe {
        let _ = esp_idf_sys::esp_websocket_client_close(h, ticks);
        let _ = esp_idf_sys::esp_websocket_client_destroy(h);
    }
    std::mem::forget(ws);
    WS_PARTIAL.lock().unwrap().clear();
    WS_CONNECTED.store(false, Ordering::Relaxed);
}

fn new_ws() -> Option<EspWebSocketClient<'static>> {
    let cfg = EspWebSocketClientConfig {
        crt_bundle_attach: Some(esp_idf_sys::esp_crt_bundle_attach),
        buffer_size: WS_BUF,
        task_stack: 6144,
        ping_interval_sec: Duration::from_secs(30),
        // The API answers 429 (Retry-After: 10) to rapid reconnects; stay well clear.
        reconnect_timeout_ms: Duration::from_secs(30),
        network_timeout_ms: Duration::from_secs(10),
        ..Default::default()
    };
    // A message larger than the buffer arrives as several Text events: the
    // first starts with '{', the rest don't. Stitch them back together.
    let cb = move |ev: &Result<esp_idf_svc::ws::client::WebSocketEvent<'_>, esp_idf_svc::io::EspIOError>| {
        let Ok(ev) = ev else { return };
        match &ev.event_type {
            WebSocketEventType::Connected => {
                WS_CONNECTED.store(true, Ordering::Relaxed);
                info!("[WS] connected, internal heap {} B", internal_free());
            }
            WebSocketEventType::Disconnected | WebSocketEventType::Closed | WebSocketEventType::Close(_) => {
                WS_CONNECTED.store(false, Ordering::Relaxed);
                WS_PARTIAL.lock().unwrap().clear();
                info!("[WS] disconnected");
            }
            WebSocketEventType::Text(t) => {
                let mut partial = WS_PARTIAL.lock().unwrap();
                if t.starts_with('{') {
                    partial.clear();
                }
                if t.starts_with('{') || !partial.is_empty() {
                    if partial.len() + t.len() > WS_MSG_MAX { partial.clear(); return; }
                    partial.push_str(t);
                    if partial.trim_end().ends_with('}') {
                        ws_dispatch(&partial);
                        partial.clear();
                        partial.shrink_to(0);
                    }
                }
            }
            _ => {}
        }
    };
    EspWebSocketClient::new(URL_WS, &cfg, Duration::from_secs(10), cb)
        .map_err(|e| warn!("[WS] create failed: {:?}", e))
        .ok()
}

/// Spawn the polling thread. It waits for WiFi and a synced clock (TLS cert
/// validity) before the first request.
pub fn start() {
    let r = thread::Builder::new()
        .name("quake".into())
        // Measured: at most ~5 KB of the old 20 KB was ever used (high-water mark
        // 15360 B free). This stack lives in scarce internal RAM, so keep it lean.
        .stack_size(10240)
        .spawn(|| {
            if cfg!(feature = "quake-sandbox") {
                warn!("[QUAKE] SANDBOX mode: using api-v2-sandbox.p2pquake.net, EEW freshness check disabled");
            }
            let mut client: Option<HttpClient> = None;
            let mut ws: Option<EspWebSocketClient<'static>> = None;
            let mut ws_since = 0u64;           // when the current WS client was created
            let mut next_quake = 0u64;
            let mut next_eew = 0u64;           // REST EEW poll (boot catch-up + WS fallback)
            let mut booted_eew = false;
            let mut last_eew_id = String::new();
            let mut last_low_warn = 0u64;
            loop {
                // Map fetch worker asked for the memory: drop the WebSocket.
                if WS_RELEASE.swap(false, Ordering::Relaxed) && ws.is_some() {
                    if let Some(w) = ws.take() { drop_ws(w); }
                    WS_CONNECTED.store(false, Ordering::Relaxed);
                    WS_ALIVE.store(false, Ordering::Relaxed);
                    client = None;
                    // Re-create ~8 s after the fetch ends (avoids 429s from churn).
                    ws_since = now_secs().saturating_sub(30 - 8);
                    info!("[WS] released for map fetch, internal heap {} B", internal_free());
                }

                let now = now_secs();
                // 2024-01-01 00:00:00 UTC: clock is synced (GPS or NTP)
                let ready = now > 1_704_067_200 && crate::wifi::is_sta_connected();

                // Expire the EEW banner / TFT overlay.
                if EEW.lock().unwrap().as_ref().map(|e| now >= e.expires).unwrap_or(false) {
                    clear_eew();
                }
                // Expire the "new earthquake" map view and give the map back.
                if NEWQ.lock().unwrap().as_ref().map(|n| now >= n.expires).unwrap_or(false) {
                    clear_new_quake();
                    if EEW.lock().unwrap().is_none() { clear_focus(); }
                }

                // Earthquake info pushed over the WebSocket.
                if let Some(msg) = WS_QUAKE_PENDING.lock().unwrap().take() {
                    merge_pushed(msg.as_bytes());
                }

                // EEW pushed over the WebSocket.
                if let Some(msg) = WS_EEW_PENDING.lock().unwrap().take() {
                    handle_eew(msg.as_bytes(), &mut last_eew_id);
                }

                if ready {
                    // (Re)create the WebSocket client; it reconnects by itself,
                    // so only replace it when it has been stuck for a while.
                    let ws_up = WS_CONNECTED.load(Ordering::Relaxed);
                    if ws.is_some() && !ws_up && now.saturating_sub(ws_since) > 180 {
                        warn!("[WS] not connected after 180 s, recreating");
                        if let Some(w) = ws.take() { drop_ws(w); }
                        WS_ALIVE.store(false, Ordering::Relaxed);
                    }
                    if ws.is_none() && now.saturating_sub(ws_since) >= 30 && !crate::map_display::is_busy()
                        && (now as u32).saturating_sub(LAST_MAP_FETCH_SECS.load(Ordering::Relaxed)) >= WS_RESUME_AFTER_MAP_SECS {
                        ws_since = now;
                        if internal_free() >= WS_MIN_INTERNAL_FREE {
                            let before = internal_free();
                            ws = new_ws();
                            WS_ALIVE.store(ws.is_some(), Ordering::Relaxed);
                            // Catch up on any EEW issued while the socket was down.
                            booted_eew = false;
                            next_eew = 0;
                            info!("[WS] client created, internal heap {} -> {} B", before, internal_free());
                        } else {
                            warn!("[WS] internal heap low ({} B), not starting", internal_free());
                        }
                    }

                    if internal_free() < MIN_INTERNAL_FREE {
                        if now.saturating_sub(last_low_warn) >= 30 {
                            last_low_warn = now;
                            warn!("[QUAKE] internal heap low ({} B), skipping REST polls", internal_free());
                        }
                        client = None; // also frees the TLS context
                    } else {
                        // EEW over REST: once at boot (an event may be in progress),
                        // then only while the WebSocket is down.
                        // Not while the map is being used either: the socket is down on
                        // purpose then, and the catch-up after it returns covers that gap.
                        let map_quiet = (now as u32).saturating_sub(LAST_MAP_FETCH_SECS.load(Ordering::Relaxed)) >= WS_RESUME_AFTER_MAP_SECS;
                        if now >= next_eew && (!booted_eew || !ws_up) && !crate::map_display::is_busy() && map_quiet {
                            booted_eew = true;
                            next_eew = now + EEW_POLL_SECS;
                            if let Some(body) = http_get(&mut client, URL_EEW) {
                                handle_eew(&body, &mut last_eew_id);
                                info!("[EEW] REST check done, stack high-water {} B free", stack_free());
                            }
                        }
                        // The list is pushed over the WebSocket, so REST is only the initial
                        // load, a slow safety re-sync, and the fallback while the socket is
                        // down. Never while a map tile fetch (TLS + JPEG) is in flight: both
                        // need internal RAM at the same time.
                        if now >= next_quake && !crate::map_display::is_busy() {
                            next_quake = now + if ws_up { QUAKE_RESYNC_SECS } else { POLL_SECS };
                            let before = internal_free();
                            match http_get(&mut client, URL_QUAKE).and_then(|b| parse(&b)) {
                                Some(list) => {
                                    let mut cur = QUAKES.lock().unwrap();
                                    let changed = cur.len() != list.len()
                                        || cur.iter().zip(list.iter()).any(|(a, b)| a.time != b.time || a.lat != b.lat || a.lon != b.lon);
                                    if changed {
                                        info!("[QUAKE] {} event(s), latest: {}",
                                              list.len(), list.first().map(|q| q.time.as_str()).unwrap_or("-"));
                                        *cur = list;
                                        VERSION.fetch_add(1, Ordering::Relaxed);
                                    }
                                    LAST_OK_SECS.store(now_secs() as u32, Ordering::Relaxed);
                                }
                                None => info!("[QUAKE] fetch failed, retry in {}s", POLL_SECS),
                            }
                            info!("[QUAKE] internal heap {} -> {} B, stack high-water {} B free", before, internal_free(), stack_free());
                        }
                        // With the WebSocket carrying EEW, don't hold a second TLS
                        // session open between the (rare) REST polls.
                        if ws_up { client = None; }
                    }
                }
                thread::sleep(Duration::from_millis(if ready { 100 } else { 5000 }));
            }
        });
    if r.is_err() {
        warn!("[QUAKE] thread spawn failed");
    }
}
