hnz1102/GNNS-viewwer/(commit log)

2026-10-10 Add schematic pdf
2026-10-10 Add STL data
2026-10-12 Add TFT page sample generator, GNSS/button legend and version info
    - Split page drawing out of serial_display.rs into display_pages.rs
    (no ESP-IDF dependency) so it can be rendered on the host.
    - Add tools/screenshots: renders every TFT page to PNG with stubbed data
    and real Google Static Maps tiles (key read from env/cfg.toml, not stored);
    samples are in docs/images/tft.
    - Unified button legend (yellow page button, blue +UP / -DOWN, red action
    button) drawn on its own row so it no longer overlaps the MAP info bar.
    - Swap UP/DOWN direction in the SAVED TRACKS and EARTHQUAKE lists.
    - Rename GPS to GNSS on the status page header and fix labels.
    - Show firmware version and build date/ti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
