hnz1102/GNNS-viewwer/(notices)

Notices in the files:
hw/GNSS-satellite-viewer.kicad_pcb:
(C) 2026 HNZ
hw/GNSS-satellite-viewer.kicad_sch:
Licensed under CC-BY-SA V4.0
(C) 2026 Hiroshi Nakajima
